patoiribe10-sys/autonomo-v2-pcb/hardware/PCB_Autonomo_V2_agujeros_M3.dxf

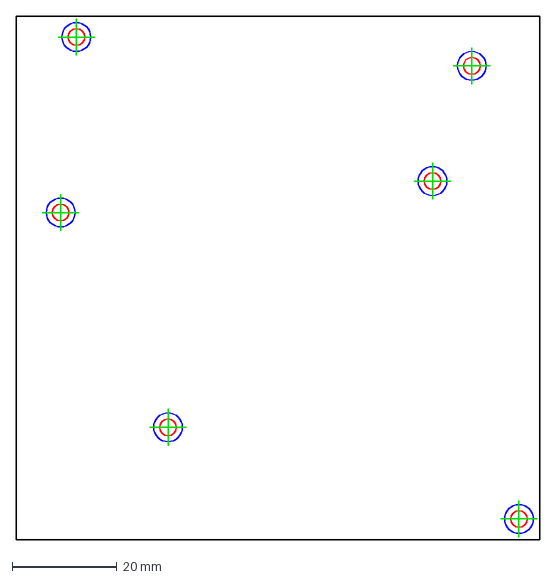
[picture p18: CAD file, 2026-11-13]
hardware/PCB_Autonomo_V2_agujeros_M3.dxf
100.0 x 100.0 mm
