patoiribe10-sys/autonomo-v2-pcb/hardware/Autonomo_V2_esquematico.pdf

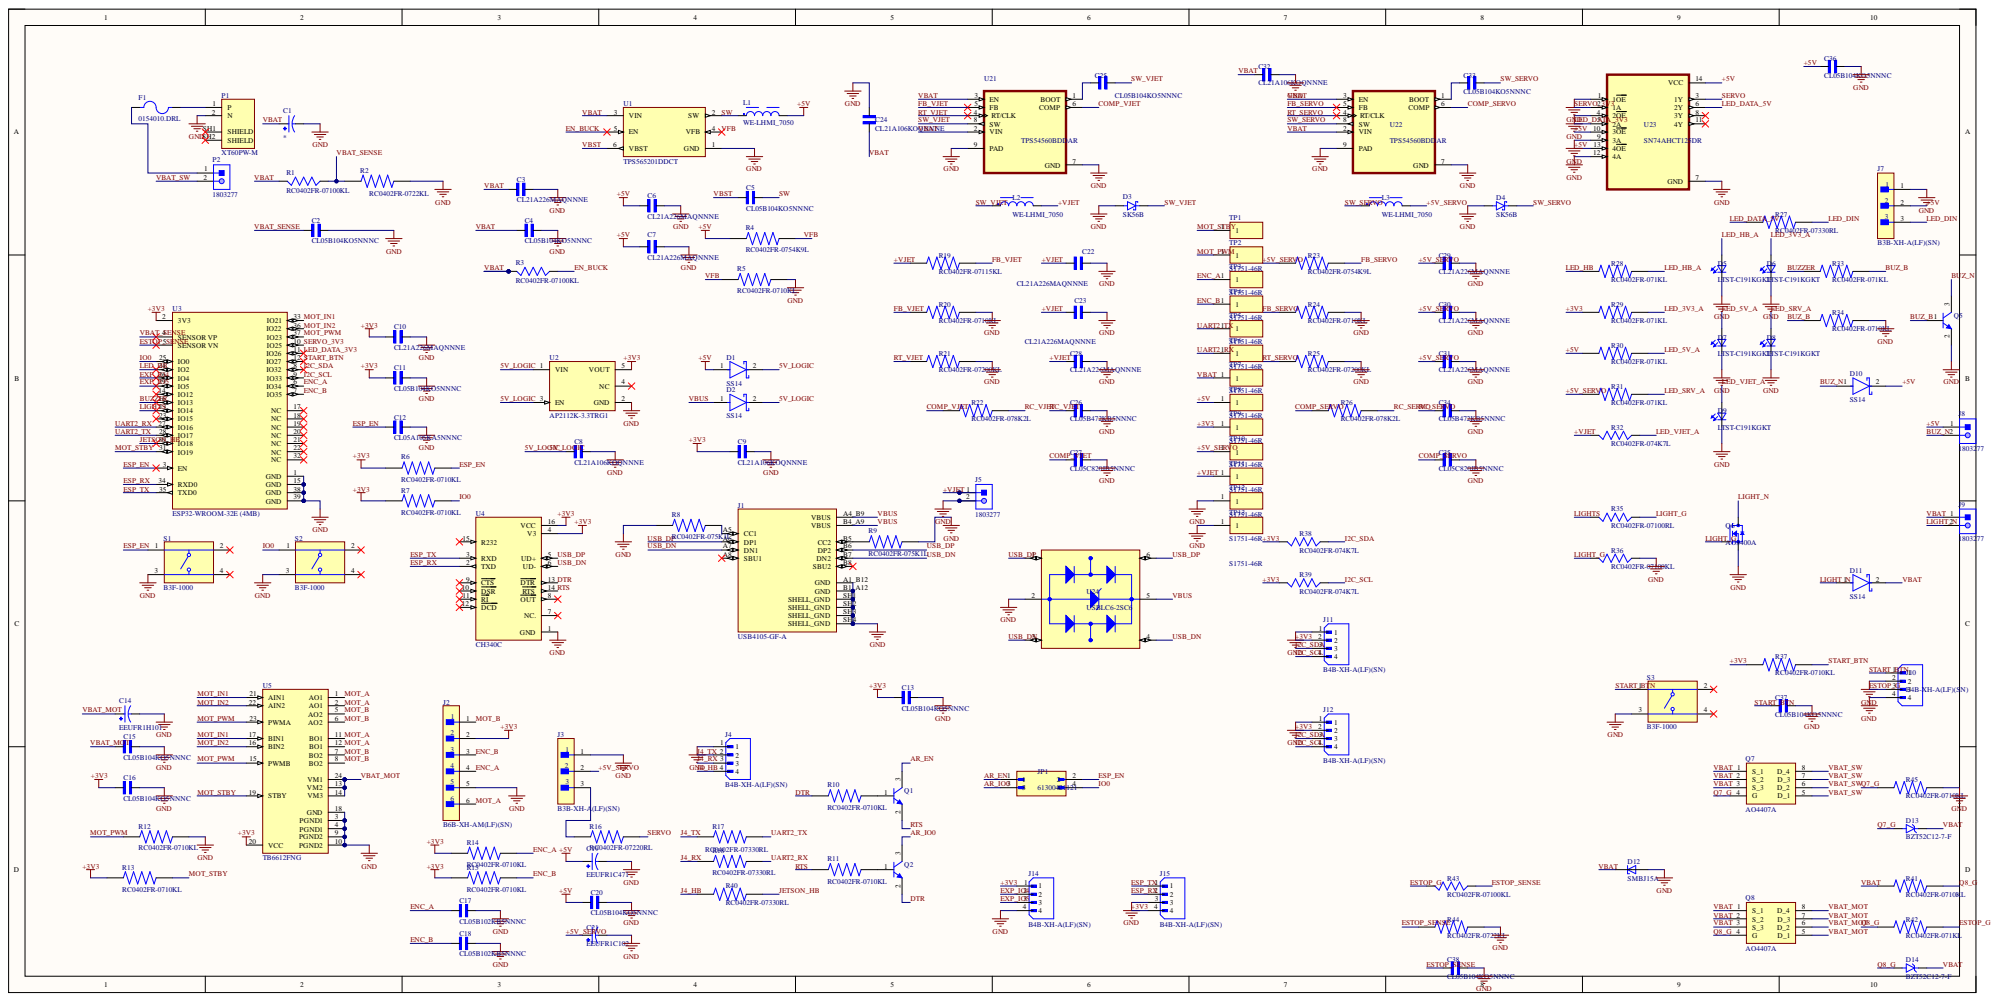
[picture p19: page 1]
