patoiribe10-sys/autonomo-v2-pcb/(commit log)

2026-11-13 Documentación de la PCB Autonomo_V2: sitio, archivos de diseño y firmware de prueba
    [PCB_Autonomo_V2_agujeros_M3.dxf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]
2026-11-13 Quita la carpeta reporte de los índices
2026-11-13 Diagramas rediseñados, vista superior 3D de la placa y limpieza del repo
    - Diagramas con pasos numerados, leyenda y colores por tipo de señal
    - Vista superior del modelo 3D en lugar de la perspectiva
    - .gitignore, imágenes sin uso eliminadas y PNG comprimidos
2026-11-13 Textos más sencillos de leer
2026-11-13 Agrega el reporte técnico en PDF
2026-11-13 Agrega licencias (CC BY 4.0 y MIT para el firmware) y corrige la portada del reporte
2026-11-13 Actualiza el reporte en PDF (sin saltos de página, esquemático en hoja horizontal)
